ocalmerd/HUMA-mini/HARDWARE/Project Outputs for Project_HUMA-mini/BOM/Bill of Materials-Project_HUMA-mini.xlsx

Comment | Description | Designator | Footprint | LibRef | Quantity
WS-TATV THT | WS-TATV THT Tact Switch 6x6mm, height 5mm, 260gf | B1 | 4301x60507x6 | 430156050726 | 1
20pF | CAP CER 20PF 50V NP0 0805 | C1, C2 | SMD-0805C | GQM2195C1H200JB01D | 2
0.10µF | CAP CER 0.1UF 25V X7R 0805, CAP CER 0.1UF 10V U2J 0805 | C3, C4, C7, C8, C9, C12, C13, C19 | SMD-0805C | GRM219R71E104KA01D, GRM21B7U1A104JA01L | 8
1µF | CAP CER 1UF 25V X5R 0805 | C5, C11 | SMD-0805C | GRT21BR61E105KE13L | 2
6.8pF | CAP CER 6.8PF 100V NP0 0805 | C6, C10 | SMD-0805C | GQM2195C2A6R8DB01D | 2
10000pF | CAP CER 10000PF 25V X7R 0805 | C14 | SMD-0805C | LLA215R71E103MA14L | 1
10µF | CAP CER 10UF 16V X6S 0805 | C15 | SMD-0805C | GRM21BC81C106KA73L | 1
22µF | CAP CER 22UF 10V X7R 1206 | C16, C17 | SMD-1206C | GRM31CR71A226ME15L | 2
Cap2 | Capacitor | C18 | CAPR5-4X5 | Cap2 | 1
MBR0520-HT | 20V 0.5A Schottky Power Rectifier, 2-Pin SOD-123, Tape and Reel | D1, D2, D3, D4 | ONSC-SOD-123-2-425-04_V | MBR0520LT1 | 4
FERRITE BEAD 600 OHM 1206 1LN | 600 Ohms @ 100MHz 1 Signal Line Ferrite Bead 1206 (3216 Metric) 2.5A 70mOhm | F1 | IND_0805 | Ferrite 600ohm 1206(742792118) | 1
Header 5H | Header, 5-Pin, Right Angle | J1 | HDR1X5H | Header 5H | 1
433MHz Air Connector | Header, 4-Pin, Right Angle | J6 | HDR1X4H | Header 4H | 1
R9DS Receiver Connector | Header, 6-Pin, Right Angle | J7 | HDR1X6H | Header 6H | 1
DC Power Jack | DC Power Jack Connector WR-DC, Male, Right Angled, THT, 5 A, 24 V | J8 | 694106301002 | 694106301002 | 1
Red | THT LED round mono-color waterclear, WL-TMRW, Red | LD1 | Type 3mm | 151033RS03000 | 1
Light Blue | THT LED round mono-color waterclear, WL-TMRW , Blue | LD2 | Type 3mm | 151033BS03000 | 1
ESC1 Connector | Header, 3-Pin, Right Angle | M1 | HDR1X3H | Header 3H | 1
ESC2 Connector | Header, 3-Pin, Right Angle | M2 | HDR1X3H | Header 3H | 1
ESC3 Connector | Header, 3-Pin, Right Angle | M3 | HDR1X3H | Header 3H | 1
ESC4 Connector | Header, 3-Pin, Right Angle | M4 | HDR1X3H | Header 3H | 1
10k | RES SMD 10K OHM 1% 1/8W 0805 | R1 | SMD-0805-RES | ERJ-6ENF1002V | 1
510 | RES SMD 510 OHM 5% 1/2W 0805 | R2 | SMD-0805-RES | ERJ-P06J511V | 1
0.0 | RES SMD 0.0 OHM JUMPER 1/8W 0805 | R3, R5, R6, R7 | SMD-0805-RES | ERJ-6GEY0R00V | 4
220 | RES SMD 220 OHM 1% 1/8W 0805, RES SMD 220 OHM 5% 1/2W 0805 | R4, R12 | SMD-0805-RES | ERJ-6ENF2200V, ERJ-P6WJ221V | 2
100 | RES SMD 100 OHM 5% 1/2W 0805 | R8 | SMD-0805-RES | ERJ-P06J101V | 1
330 | RES SMD 330 OHM 5% 1/2W 0805 | R9 | SMD-0805-RES | ERJ-P6WJ331V | 1
220k | RES SMD 220K OHM 5% 1/2W 0805 | R10 | SMD-0805-RES | ERJ-P06J224V | 1
470 | RES SMD 470 OHM 5% 1/2W 0805 | R11 | SMD-0805-RES | ERJ-P6WJ471V | 1
STM32F303CCT6 | ARM Cortex-M4 32-bit MCU, 256 KB Flash, 40 KB Internal RAM, 37 I/Os, 48-pin LQFP, -40 to 85 degC, Tray | U1 | STM-LQFP48_N | STM32F303CCT6 | 1
L3GD20TR | Gyroscope X (Pitch), Y (Roll), Z (Yaw) ±250, 500, 2000 47.5Hz ~ 380Hz I²C, SPI 16-LGA (4x4) | U2 | LGA16C65P6X6_400X400X100 | L3GD20TR | 1
AMS1117_5V | Sot223/Pkg 1-Amp Low Drop Out Voltage Regulator | U3 | *SOT229P700X180-4N | AMS1117 | 1
AMS1117_3V3 | Sot223/Pkg 1-Amp Low Drop Out Voltage Regulator | U4 | *SOT229P700X180-4N | AMS1117 | 1
8MHz | Crystal; Frequency: 8MHz; Frequency | X1 | OSC488W43P488L465H350Q2P | XTAL8MHz | 1
XTAL | Crystal Oscillator | X2 | R38 | XTAL | 1
