ocalmerd/HUMA-mini/HARDWARE/Project Outputs for Project_HUMA-mini/ExportSTEP/PCB_HUMA-mini.step

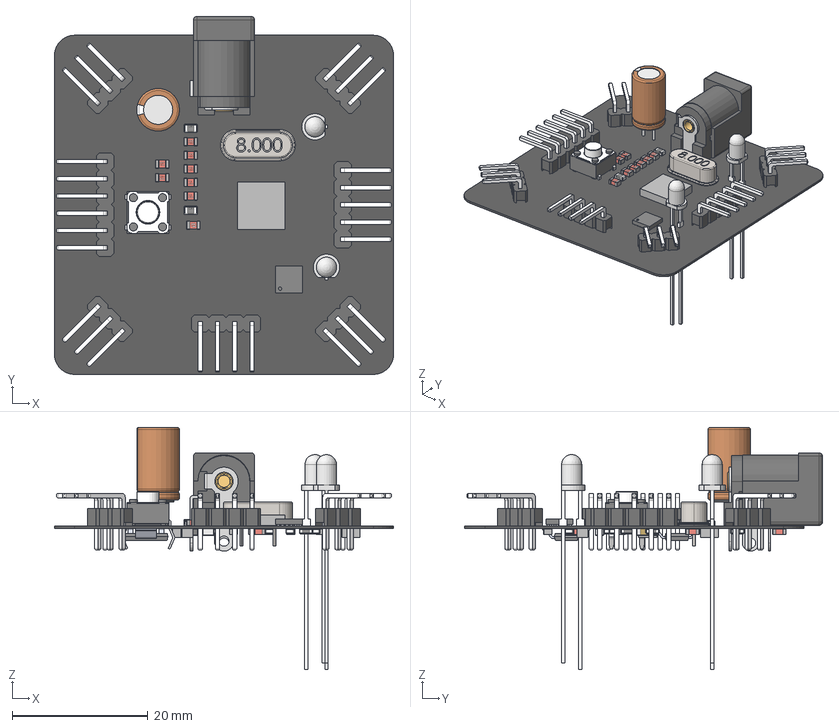
[picture p1: CAD file, 2020-09-05]
HARDWARE/Project Outputs for Project_HUMA-mini/ExportSTEP/PCB_HUMA-mini.step
50.0 x 52.8 x 35.7 mm
SW3dPS-0805_SMD_Resistor x 12
WL-TMRW_3mm x 2
capacitor_0805 x 16
4301x60507x6
6941xx301002
694106301002_PinContact
6941xx301002_Back
6941xx301002_PinContact2
6941xx301002_PinLame
6941xx301002_PinBis
AMS1117-3.3--3DModel-STEP-56544 x 2
Extruded x 5
capacitor_1206 x 2
crystal_oscillator
Open_CASCADE_STEP_translator_6.8_1.1
Open_CASCADE_STEP_translator_6.8_1.2.1
pinShape x 20
Open_CASCADE_STEP_translator_6.8_38.1.1
Open_CASCADE_STEP_translator_6.8_38.1.2
Open_CASCADE_STEP_translator_6.8_38.2.1
Aluminum_electrolytic_capacitor_radial_D6.3_H11_PinD0.5_Pitch2.5_ nominal_brown x 5
