ocalmerd/HUMA-mini/HARDWARE/Project Outputs for Project_HUMA-mini/PCB_HUMA-mini.pdf

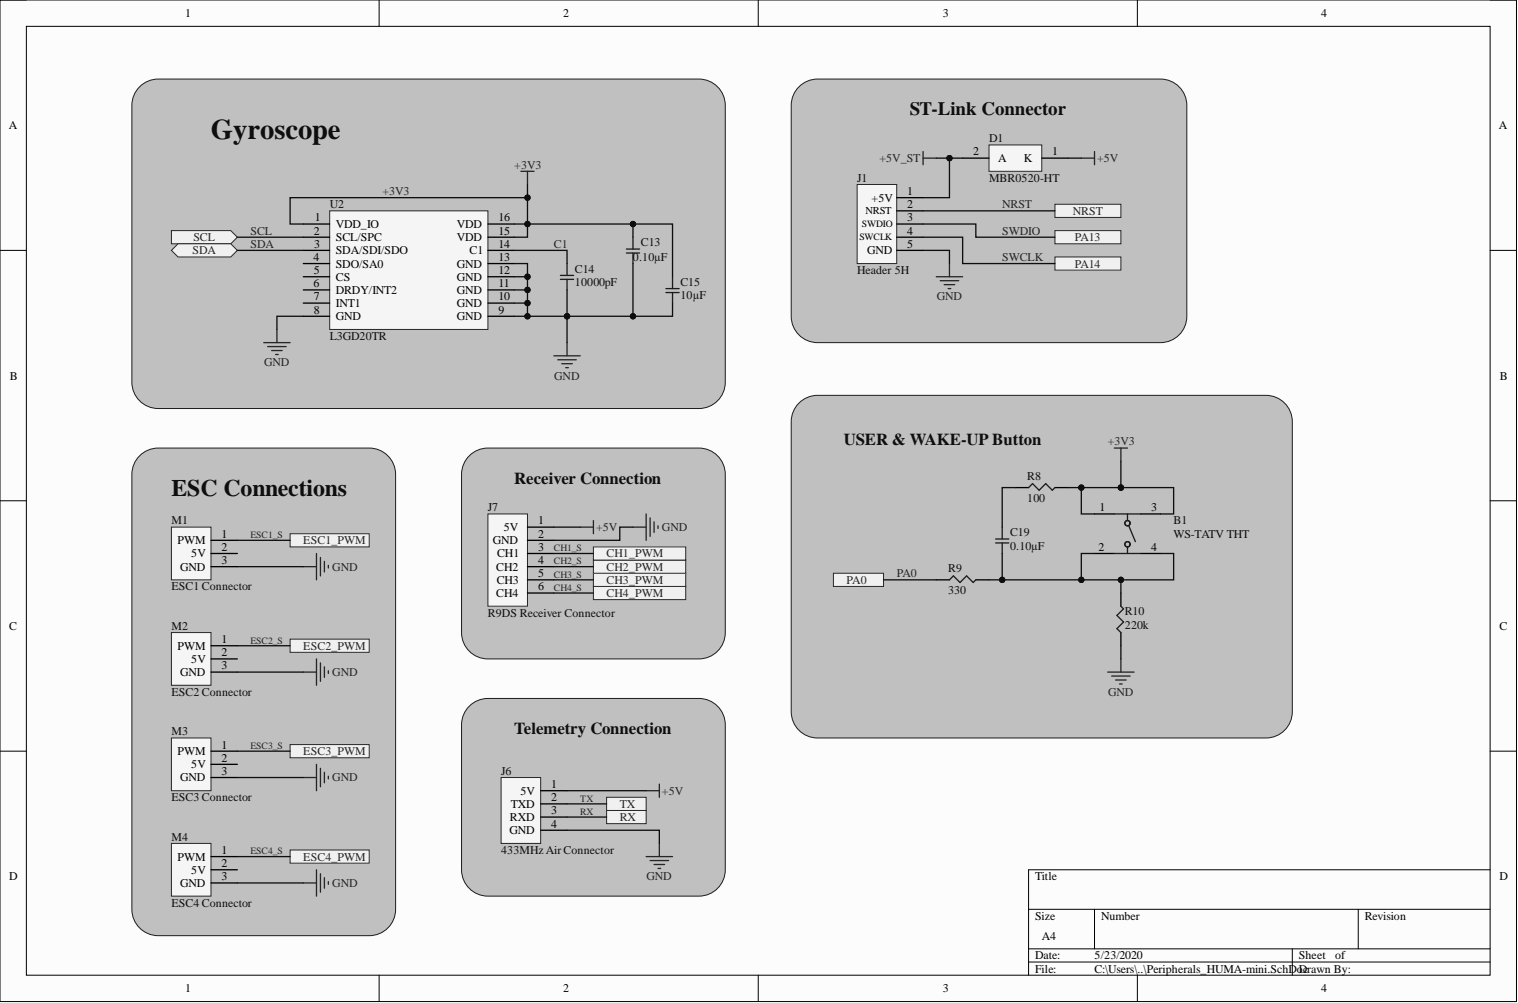
[picture p4: page 1]

USER & WAKE-UP Button

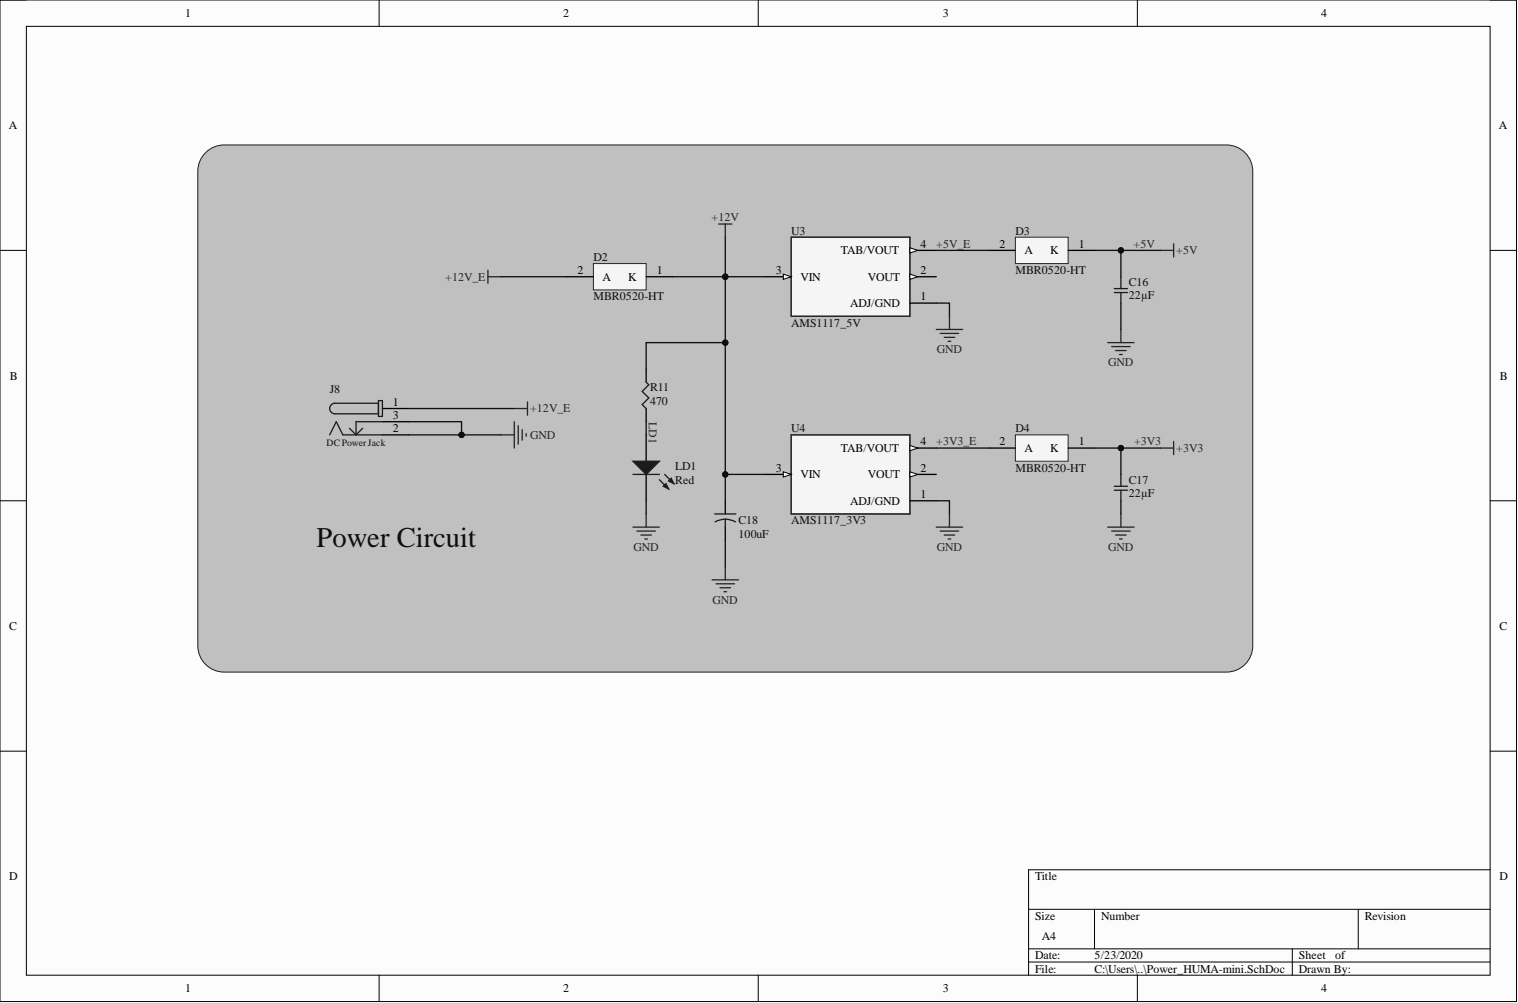
[picture p5: page 2]

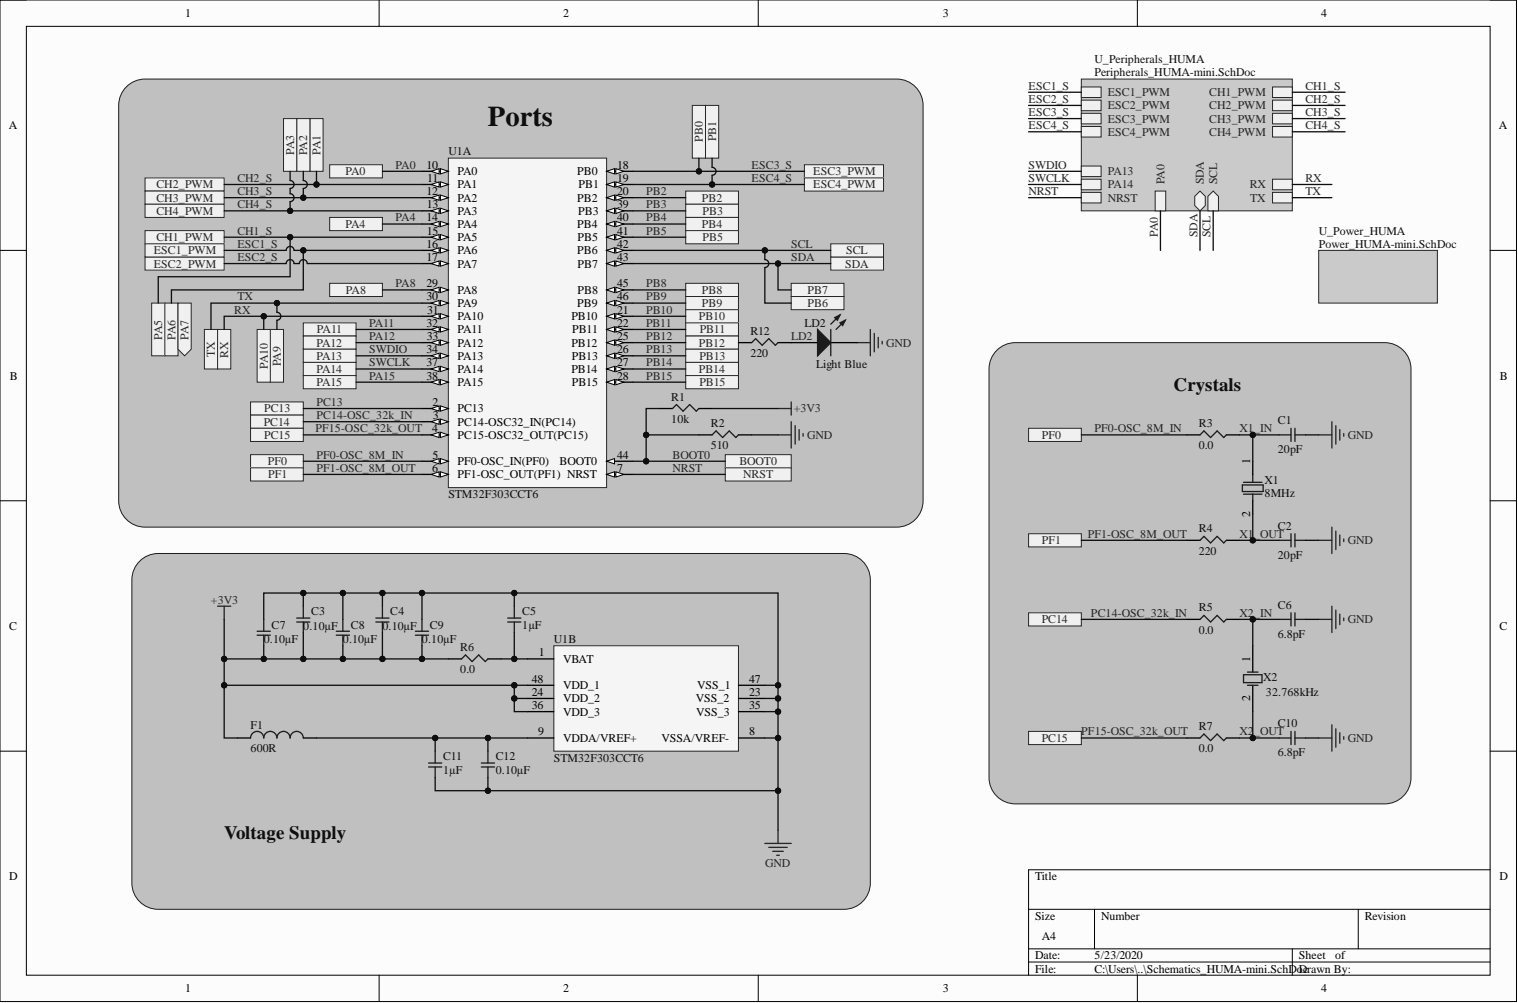
[picture p6: page 3]

CH 3 _PW M | | | PB2
CH 4 _PW M | | | PB3

CH 3 _ S | 1 2
CH 4 _ S | 1 3 | 3 9 PB3

ESC1 | | | | | SCL
ESC2 | | _PW M | | | | SD A

ESC1 _ S | 1 6
ESC2 _ S | | 1 7 | 4 3 | SD A

PA 1 2 | | | PB1 2
PA 1 3 | | | PB1 3

PA 1 2 3 3 | 2 5 PB1 2
SW D I O 3 4 | 2 6 PB1 3
SWCL K 3 7 | 2 7 PB1 4
PA 1 5 3 8 | 2 8 PB1 5

PF1 | NRST

PF1-OSC_ 8M_ O U T 6 | NRST

2 4 | | 2 3
3 6 | | 3 5

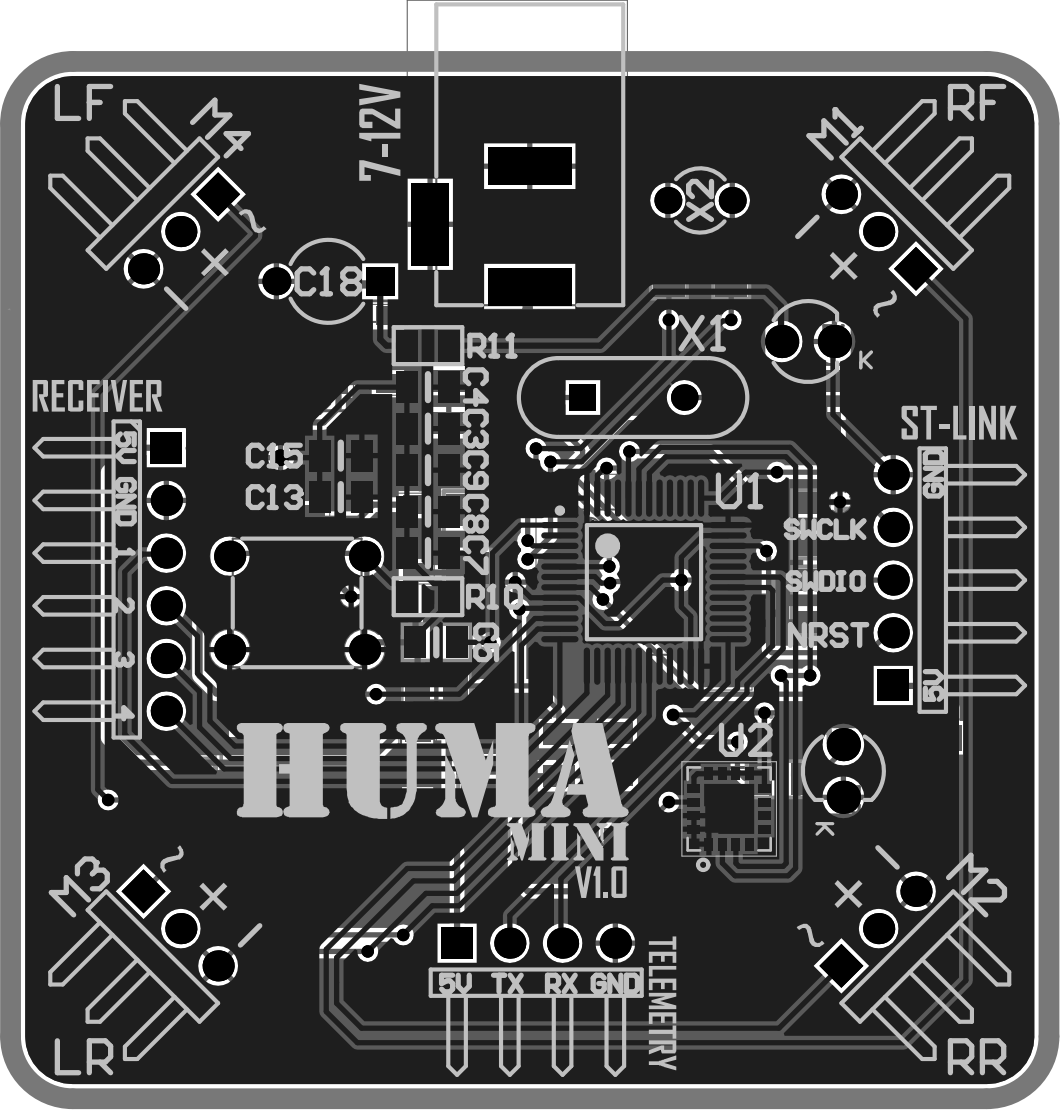
[picture p7: page 4]
