ocalmerd/HUMA-mini/(list of files, drawings)

Other design files:
HARDWARE/PCB_HUMA-mini.PcbDoc
HARDWARE/Peripherals_HUMA-mini.SchDoc
HARDWARE/Power_HUMA-mini.SchDoc
HARDWARE/Project_HUMA-mini.PrjPcb
HARDWARE/Schematics_HUMA-mini.SchDoc
