ocalmerd/HUMA-mini/SOFTWARE/Core/Src/main.c

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
/* Includes ------------------------------------------------------------------*/
#include "main.h"

/* USER CODE BEGIN Includes */
#include "PWM_IC.h"
#include "L3GD20H.h"
///
#include "Setup_FC.h"
#include "ESC_Calibration.h"
#include "Flight_Control.h"

/* USER CODE END Includes */

/* USER CODE BEGIN PTD */
char uartTX[101];
///	Inputs
int receiver_input_channel_1, receiver_input_channel_2, receiver_input_channel_3, receiver_input_channel_4;
int16_t gX_Raw, gY_Raw, gZ_Raw;
///
bool gyro_error;
bool setup_error;
///	Outputs
int esc_1, esc_2, esc_3, esc_4;
double gyro_pitch, gyro_roll, gyro_yaw;
///
uint8_t eeprom_data8[32] = {0,0,0,0,0,0,0,0,0,0,0,0,0,0,0,0,0,0,0,0,0,0,0,0,0,0,0,0,0,0,0,0};
uint16_t eeprom_data16[32] = {0,0,0,0,0,0,0,0,0,0,0,0,0,0,0,0,0,0,0,0,0,0,0,0,0,0,0,0,0,0,0,0};
/* USER CODE END PTD */

I2C_HandleTypeDef hi2c1;

TIM_HandleTypeDef htim2;
TIM_HandleTypeDef htim3;

UART_HandleTypeDef huart1;

void SystemClock_Config(void);
static void MX_GPIO_Init(void);
static void MX_I2C1_Init(void);
static void MX_TIM2_Init(void);
static void MX_TIM3_Init(void);
static void MX_USART1_UART_Init(void);
/**
  * @brief  The application entry point.
  * @retval int
  */
int main(void)
{
  /* MCU Configuration--------------------------------------------------------*/

  /* Reset of all peripherals, Initializes the Flash interface and the Systick. */
  HAL_Init();

  /* Configure the system clock */
  SystemClock_Config();

  /* USER CODE BEGIN SysInit */
  HAL_Delay( 3000 );
  /* USER CODE END SysInit */

  /* Initialize all configured peripherals */
  MX_GPIO_Init();
  MX_I2C1_Init();
  MX_TIM2_Init();
  MX_TIM3_Init();
  MX_USART1_UART_Init();
  /* USER CODE BEGIN 2 */

	// Flash to EEPROM Array
	Flash_EEPROM_Data_Read( 127, 0x0803F800,  0, &eeprom_data16[0]);
	Flash_EEPROM_Data_Read( 127, 0x0803F800,  1, &eeprom_data16[1]);
	Flash_EEPROM_Data_Read( 127, 0x0803F800,  2, &eeprom_data16[2]);
	Flash_EEPROM_Data_Read( 127, 0x0803F800,  3, &eeprom_data16[3]);
	Flash_EEPROM_Data_Read( 127, 0x0803F800,  4, &eeprom_data16[4]);
	Flash_EEPROM_Data_Read( 127, 0x0803F800,  5, &eeprom_data16[5]);
	Flash_EEPROM_Data_Read( 127, 0x0803F800,  6, &eeprom_data16[6]);
	Flash_EEPROM_Data_Read( 127, 0x0803F800,  7, &eeprom_data16[7]);
	Flash_EEPROM_Data_Read( 127, 0x0803F800,  8, &eeprom_data16[8]);
	Flash_EEPROM_Data_Read( 127, 0x0803F800,  9, &eeprom_data16[9]);
	Flash_EEPROM_Data_Read( 127, 0x0803F800, 10, &eeprom_data16[10]);
	Flash_EEPROM_Data_Read( 127, 0x0803F800, 11, &eeprom_data16[11]);
	Flash_EEPROM_Data_Read( 127, 0x0803F800, 12, &eeprom_data16[12]);
	Flash_EEPROM_Data_Read( 127, 0x0803F800, 13, &eeprom_data16[13]);
	Flash_EEPROM_Data_Read( 127, 0x0803F800, 14, &eeprom_data16[14]);
	Flash_EEPROM_Data_Read( 127, 0x0803F800, 15, &eeprom_data16[15]);
	Flash_EEPROM_Data_Read( 127, 0x0803F800, 16, &eeprom_data16[16]);
	Flash_EEPROM_Data_Read( 127, 0x0803F800, 17, &eeprom_data16[17]);
	Flash_EEPROM_Data_Read( 127, 0x0803F800, 18, &eeprom_data16[18]);
	Flash_EEPROM_Data_Read( 127, 0x0803F800, 19, &eeprom_data16[19]);
	Flash_EEPROM_Data_Read( 127, 0x0803F800, 20, &eeprom_data16[20]);
	Flash_EEPROM_Data_Read( 127, 0x0803F800, 21, &eeprom_data16[21]);
	Flash_EEPROM_Data_Read( 127, 0x0803F800, 22, &eeprom_data16[22]);
	Flash_EEPROM_Data_Read( 127, 0x0803F800, 23, &eeprom_data16[23]);
	Flash_EEPROM_Data_Read( 127, 0x0803F800, 24, &eeprom_data16[24]);
	Flash_EEPROM_Data_Read( 127, 0x0803F800, 25, &eeprom_data16[25]);
	Flash_EEPROM_Data_Read( 127, 0x0803F800, 26, &eeprom_data16[26]);
	Flash_EEPROM_Data_Read( 127, 0x0803F800, 27, &eeprom_data16[27]);
	Flash_EEPROM_Data_Read( 127, 0x0803F800, 28, &eeprom_data16[28]);
	Flash_EEPROM_Data_Read( 127, 0x0803F800, 29, &eeprom_data16[29]);
	Flash_EEPROM_Data_Read( 127, 0x0803F800, 30, &eeprom_data16[30]);
	Flash_EEPROM_Data_Read( 127, 0x0803F800, 31, &eeprom_data16[31]);

  eeprom_data8[0]   = eeprom_data16[0];
  eeprom_data8[1]   = eeprom_data16[1];
  eeprom_data8[2]   = eeprom_data16[2];
  eeprom_data8[3]   = eeprom_data16[3];
  eeprom_data8[4]   = eeprom_data16[4];
  eeprom_data8[5]   = eeprom_data16[5];
  eeprom_data8[6]   = eeprom_data16[6];
  eeprom_data8[7]   = eeprom_data16[7];
  eeprom_data8[8]   = eeprom_data16[8];
  eeprom_data8[9]   = eeprom_data16[9];
  eeprom_data8[10]  = eeprom_data16[10];
  eeprom_data8[11]  = eeprom_data16[11];
  eeprom_data8[12]  = eeprom_data16[12];
  eeprom_data8[13]  = eeprom_data16[13];
  eeprom_data8[14]  = eeprom_data16[14];
  eeprom_data8[15]  = eeprom_data16[15];
  eeprom_data8[16]  = eeprom_data16[16];
  eeprom_data8[17]  = eeprom_data16[17];
  eeprom_data8[18]  = eeprom_data16[18];
  eeprom_data8[19]  = eeprom_data16[19];
  eeprom_data8[20]  = eeprom_data16[20];
  eeprom_data8[21]  = eeprom_data16[21];
  eeprom_data8[22]  = eeprom_data16[22];
  eeprom_data8[23]  = eeprom_data16[23];
  eeprom_data8[24]  = eeprom_data16[24];
  eeprom_data8[25]  = eeprom_data16[25];
  eeprom_data8[26]  = eeprom_data16[26];
  eeprom_data8[27]  = eeprom_data16[27];
  eeprom_data8[28]  = eeprom_data16[28];
  eeprom_data8[29]  = eeprom_data16[29];
  eeprom_data8[30]  = eeprom_data16[30];
  eeprom_data8[31]  = eeprom_data16[31];

	L3GD20H_Init();
	PWM_IC_Start();
	///
	HAL_Delay( 2500 );

	/////////////////////////////////////////////////////////////////////////


	if( gyro_error == false )
	{
		sprintf(uartTX, "                                                                                                    ");
		sprintf(uartTX, "\nSystem started!\n");
		HAL_UART_Transmit( &huart1, (uint8_t *)uartTX, sizeof(uartTX), 100 );
		HAL_Delay( 2500 );
	}
	else if( gyro_error == true )
	{
		  sprintf(uartTX, "                                                                                                    ");
		  sprintf(uartTX, "\nSystem failed to start!\n");
		  HAL_UART_Transmit( &huart1, (uint8_t *)uartTX, sizeof(uartTX), 100 );

		  while ( gyro_error ) {	} 		// Endless Loop
	}
	else
	{
		  sprintf(uartTX, "                                                                                                    ");
		  sprintf(uartTX, "\nOh shit!\n");
		  HAL_UART_Transmit( &huart1, (uint8_t *)uartTX, sizeof(uartTX), 100 );
	}

	/////////////////////////////////////////////////////////////////////////

	if ( eeprom_data8[31] == 92 && gyro_error == false )
	{
		while ( HAL_GPIO_ReadPin(GPIOA, GPIO_PIN_0) )
		{
			for (int i = 0; i <= 50000000; i++ )
			{
				if( i == 50000000 && HAL_GPIO_ReadPin(GPIOA, GPIO_PIN_0) )
				{
					sprintf(uartTX, "                                                                                                    ");
					sprintf(uartTX, "\nESC Calibration is starting! Reset after calibration!\n");
					HAL_UART_Transmit( &huart1, (uint8_t *)uartTX, sizeof(uartTX), 100 );

					ESC_Calibration();
				}
			}
		}


		sprintf(uartTX, "                                                                                                    ");
		sprintf(uartTX, "\nFlight Setup is starting!\n");
		HAL_UART_Transmit( &huart1, (uint8_t *)uartTX, sizeof(uartTX), 100 );

		Flight_Control_Setup();

		sprintf(uartTX, "                                                                                                    ");
		sprintf(uartTX, "\nFlight Setup is done! Ready to fly!\n");
		HAL_UART_Transmit( &huart1, (uint8_t *)uartTX, sizeof(uartTX), 100 );
	}
	else
	{
		setup_error = true;

		sprintf(uartTX, "                                                                                                    ");
		sprintf(uartTX, "\nMain Setup has not been done correctly!\n");
		HAL_UART_Transmit( &huart1, (uint8_t *)uartTX, sizeof(uartTX), 100 );

		while ( setup_error )
		{
			if ( HAL_GPIO_ReadPin(GPIOA, GPIO_PIN_0) )
			{
				for (int i = 0; i <= 50000000; i++ )
				{
					if( i == 50000000 && HAL_GPIO_ReadPin(GPIOA, GPIO_PIN_0) )
					{
						sprintf(uartTX, "                                                                                                    ");
						sprintf(uartTX, "\nSetup is starting..!\n");
						HAL_UART_Transmit( &huart1, (uint8_t *)uartTX, sizeof(uartTX), 100 );

						Main_Setup( );
					}
				}
			}
		}
	}

  /* USER CODE END 2 */

  /* Infinite loop */
  /* USER CODE BEGIN WHILE */
  while (1)
  {
    /* USER CODE END WHILE */

    /* USER CODE BEGIN 3 */

//	  Flight_Control_Loop();			// Causes HARDFAULT !!!

  }
  /* USER CODE END 3 */
}

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
