ocalmerd/HUMA-mini/SOFTWARE/Core/Inc/main.h

#define USER_BUTTON_Pin GPIO_PIN_0
#define USER_BUTTON_GPIO_Port GPIOA
#define BOOT1_Pin GPIO_PIN_2
#define BOOT1_GPIO_Port GPIOB
#define LED_Pin GPIO_PIN_12
#define LED_GPIO_Port GPIOB
